JesusMartinezAre/mondelez_checkouts/caja/stl/caja_base.stl

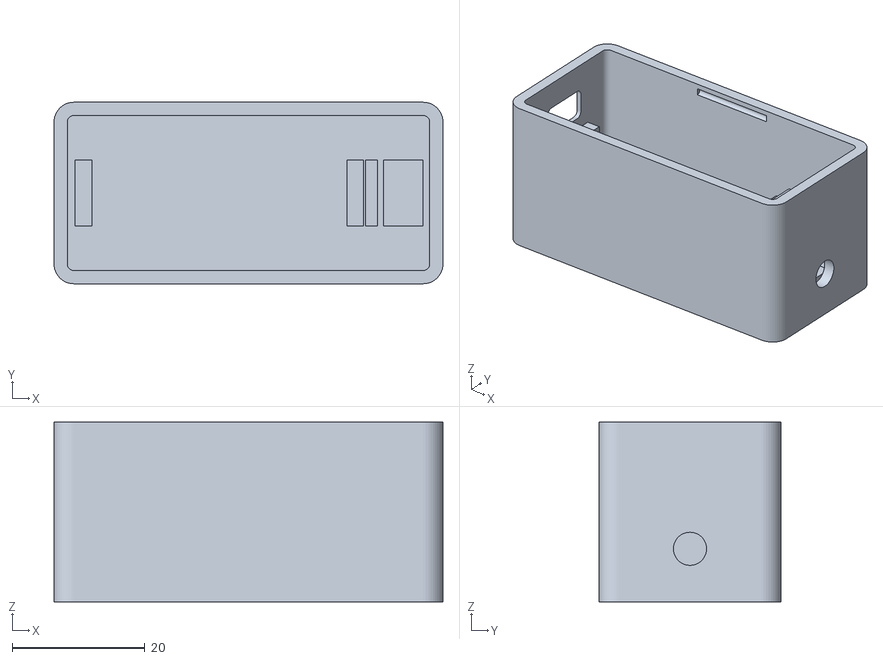
[picture p1: CAD file, 2026-11-13]
caja/stl/caja_base.stl
58.7 x 27.4 x 27.1
