JesusMartinezAre/mondelez_checkouts/caja/stl/caja_tapa.stl

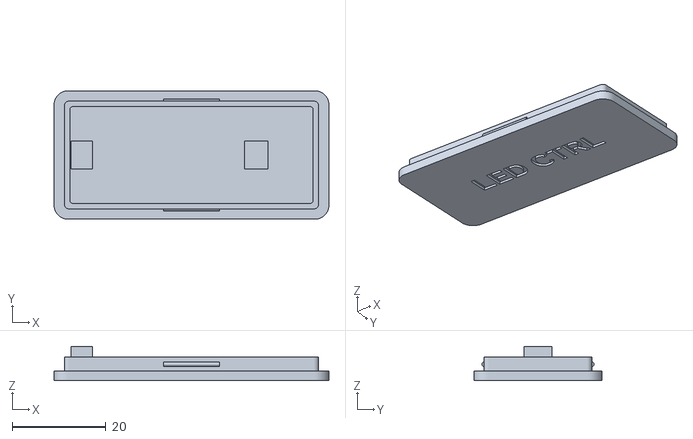
[picture p2: CAD file, 2026-11-13]
caja/stl/caja_tapa.stl
58.7 x 27.4 x 7.30
